chengggguo/becomingRipples_corridor/arduino/devices/190cmBar_device/README.md

# 190cmBar 装置自主循环测试代码

`190cmBar_device.ino` 用来单独测试一台 190cmBar 装置的机械部分。它不等待人体传感器或继电器信号；Arduino Uno 通电后会自动归零，然后持续随机移动并推动舵机。

这不是现场联动的正式代码。需要接收外部 RUN 和 RESET 信号时，请使用：

```text
arduino/devices/190cmBar_device_status_led/190cmBar_device_status_led.ino
```

## 接线和引脚

```text
D4        -> 左步进电机 DIR
D5        -> 左步进电机 STEP
D6        -> 右步进电机 STEP
D7        -> 右步进电机 DIR
D8        -> 左步进驱动器 ENABLE
D9        -> 右步进驱动器 ENABLE
D10       -> 舵机
D11       <- 左 Hall 传感器
D12       <- 右 Hall 传感器
```

D2、D3 在这份测试代码中不使用，不需要连接 RUN 或 RESET 继电器。D13 也没有状态灯功能。

## 通电后的循环

1. 通电后立即执行 `autoHome()`。
2. 左右两侧分别取得 D11、D12 的 Hall 信号，建立机械原点。
3. 在绘画范围内选择一个随机位置，并驱动两台步进电机移动过去。
4. 到达随机位置后，舵机从休息角度 19° 推到 54°，然后回到 19°。
5. 舵机动作结束后等待 10 秒。
6. 再选择下一个随机位置，重复“移动 → 舵机推动 → 等待 10 秒”。

10 秒是每次舵机动作完成后的固定等待时间。两次推动之间的实际时间还包括下一次步进电机移动所需的时间。

## Auto Home

第一次通电时，代码不知道当前位置，因此会先让左右电机按安全方向各移动约 3000 步，再依次寻找左右 Hall 信号。Hall 必须连续保持 HIGH 100ms 才会被确认。

- 安全反向移动超过 15 秒仍未完成：关闭步进驱动器，等待 10 秒，然后通过 watchdog 重启。
- 单侧寻找 Hall 超过 90 秒：该侧反向移动 3200 步，再重新寻找 Hall。
- 普通随机移动超过 30 秒仍未完成：通过 watchdog 重启。

代码使用 8 秒 watchdog。固定的 10 秒等待会分成短时间片并持续刷新 watchdog，不会因为等待时间超过 8 秒而误重启。

## 与正式代码的区别

正式代码 `190cmBar_device_status_led.ino` 使用 A1 接收 RUN、A2 接收 RESET，并用 D13 显示状态。正式代码开机归零后先移动到随机待机位置，随后等待外部 RUN。

本测试代码不读取 A1、A2、D2 或 D3，也不等待外部命令；只要保持通电，就会一直执行装置本身的循环测试。
