chengggguo/becomingRipples_corridor/docs/source_files.md

# Source Files / 源文件

## 中文

### 现有输入

原始装置固件：

```text
D:/work/ownProjects/CurrentProjects/BecomingRipples/offline/proposal1/prototype/code/2025gravityMuseum/190bar/190cmBar_code/190cmBar_code.ino
```

控制方案说明文档：

```text
C:/Users/db/Downloads/网页下载/becoming_ripples_control_plan.md
```

### 当前本地输出

修改后的装置固件工作区：

```text
arduino/devices/190cmBar_device/
```

Presence group controller 固件工作区：

```text
arduino/controllers/presence_group_controller/
```

临时测试 sketch：

```text
arduino/tests/
```

LD2410 串口调参库参考：

```text
arduino/libraries/HLK_LD2410_config/
```

旧分叉或备用版本：

```text
arduino/legacy/
```

最终文件可以继续保留在这个工具箱文件夹中，也可以在测试后复制回原始 Arduino sketch 所在目录。

## English

### Existing Input

Original device firmware:

```text
D:/work/ownProjects/CurrentProjects/BecomingRipples/offline/proposal1/prototype/code/2025gravityMuseum/190bar/190cmBar_code/190cmBar_code.ino
```

Control plan document:

```text
C:/Users/db/Downloads/网页下载/becoming_ripples_control_plan.md
```

### Current Local Outputs

Modified device firmware workspace:

```text
arduino/devices/190cmBar_device/
```

Presence group controller firmware workspace:

```text
arduino/controllers/presence_group_controller/
```

Temporary diagnostic sketches:

```text
arduino/tests/
```

Reference LD2410 UART configuration library:

```text
arduino/libraries/HLK_LD2410_config/
```

Older branches or backup versions:

```text
arduino/legacy/
```

Final placement can either stay in this toolbox folder or be copied back beside the original Arduino sketches after testing.
