chengggguo/becomingRipples_corridor/(commit log)

2026-06-16 Add 190cmBar device sketch without LED path
2026-06-16 Add reset relay scheduling to presence controller
    [presence_group_controller.ino]
2026-06-16 Increase spacing between reset requests
    [presence_group_controller.ino]
2026-06-16 Add wiring guide
2026-06-16 Implement device RUN and reset control
    [190cmBar_device.ino]
2026-06-16 Add homing timeout and reset offset docs
    [190cmBar_device.ino, presence_group_controller.ino]
2026-06-16 Add standalone no-LED 190cmBar sketch
2026-06-25 Reorganize Arduino sketches
2026-06-25 Update controller reset scheduling
    [presence_group_controller_no_bus_relay_test.ino, presence_group_controller_runtime_reset_test.ino]
2026-06-25 Add row ID reset staggering
    [presence_group_controller_runtime_bus_test.ino]
2026-08-13 Add two-device presence controller version
2026-08-13 Document standalone no-run-reset device sketch
2026-08-15 Add device firmware with D13 status feedback
2026-09-04 Remove TF-Luna startup wait and simplify device guide
2026-09-04 Clarify Uno device and Nano controller boards
2026-09-04 Clarify random standby behavior after homing
2026-09-04 Switch production device inputs to A1 and A2
2026-09-05 Update TF-Luna setup and device test workflows
2026-09-05 docs: add merged TF-Luna pinout wiring image
